kethort/esp32-bluetooth-cnc-mpg-mach4/src/PCB/BOM_PCB_open_source_MPG_2_2021-04-08.csv

ID | Name | Designator | Footprint | Quantity | Manufacturer Part | Manufacturer | Supplier | Supplier Part | _Price | JLCPCB SMD | LCSC Assembly | Paste Type | Assembly Type
1 | D2 | A+ | HDR-M-2.54_1X1 | 1 |  |  | LCSC | C81276 | $0.0048
2 | D25 | ADC | HDR-M-2.54_1X1 | 1 |  |  | LCSC | C81276 | $0.0048
3 | D4 | B+ | HDR-M-2.54_1X1 | 1 |  |  | LCSC | C81276 | $0.0048
4 | BATT+ | BATT+ | HDR-M-2.54_1X1 | 1 |  |  | LCSC | C81276 | $0.0048
5 | JUMPER2 | BATT-SW | JUMPER2 | 1
6 | 100nF | C1 | C0805 | 1 | CL21B104JBCNNNC | SAMSUNG | LCSC | C62912 | $0.0205 | Yes | Yes | expand
7 | 1000uF | C3 | CAP-SMD_BD8.0-L8.3-W8.3-RD | 1 | VEJ102M0JTR-0810 | Lelon | LCSC | C134755 | $0.1113 | Yes | Yes | expand
8 | D0 | D0 | HDR-M-2.54_1X1 | 1 |  |  | LCSC | C81276 | $0.0048
9 | D32 | EN | HDR-M-2.54_1X1 | 1 |  |  | LCSC | C81276 | $0.0048
10 | EN | J2 | HDR-M-2.54_1X1 | 1 |  |  | LCSC | C81276 | $0.0048
11 | D13 | J3 | HDR-M-2.54_1X1 | 1 |  |  | LCSC | C81276 | $0.0048
12 | D15 | J4 | HDR-M-2.54_1X1 | 1 |  |  | LCSC | C81276 | $0.0048
13 | D21 | J6 | HDR-M-2.54_1X1 | 1 |  |  | LCSC | C81276 | $0.0048
14 | D19 | J7 | HDR-M-2.54_1X1 | 1 |  |  | LCSC | C81276 | $0.0048
15 | D18 | J8,J12 | HDR-M-2.54_1X1 | 2 |  |  | LCSC | C81276 | $0.0048
16 | NC | J11 | HDR-M-2.54_1X1 | 1 |  |  | LCSC | C81276 | $0.0048
17 | D23 | J5,J13 | HDR-M-2.54_1X1 | 2 |  |  | LCSC | C81276 | $0.0048
18 | D27 | J14 | HDR-M-2.54_1X1 | 1 |  |  | LCSC | C81276 | $0.0048
19 | D26 | J23 | HDR-M-2.54_1X1 | 1 |  |  | LCSC | C81276 | $0.0048
20 | 3V3 | 3V3,J10,J26,P3V | HDR-M-2.54_1X1 | 4 |  |  | LCSC | C81276 | $0.0048
21 | GND | GND,J9,J24,J29,PGND | HDR-M-2.54_1X1 | 5 |  |  | LCSC | C81276 | $0.0048
22 | 10K | R1 | R0603 | 1 | SDNT1608X103F3450FTF | Sunlord | LCSC | C95953 | $0.043 |  |  | expand | smtWeld
23 | RX | RX | HDR-M-2.54_1X1 | 1 |  |  | LCSC | C81276 | $0.0048
24 | TX | TX | HDR-M-2.54_1X1 | 1 |  |  | LCSC | C81276 | $0.0048
25 | ESP32-WROOM-32U | U1 | WIFIM-SMD_38P-L19.2-W18.0-P1.27 | 1 | ESP32-WROOM-32U | Espressif Systems | LCSC | C328062 | $3.259091 |  | Yes | expand | smtWeld
26 | HT7333-A | U4 | SOT-89-3_L4.5-W2.5-P1.50-LS4.2-BR | 1 | HT7333-A | HOLTEK | LCSC | C21583 | $0.1849 | Yes | Yes | expand | smtWeld
