kethort/esp32-bluetooth-cnc-mpg-mach4/src/3d Print Files/mpg-top.stl

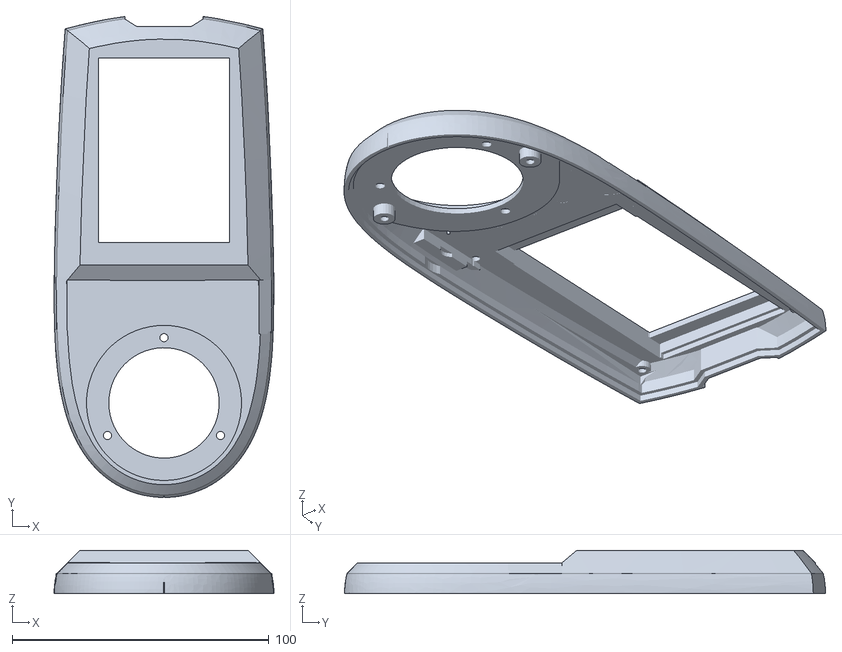
[picture p10: CAD file, 2021-04-23]
src/3d Print Files/mpg-top.stl
85.6 x 187.4 x 16.9
