kethort/esp32-bluetooth-cnc-mpg-mach4/src/3d Print Files/screen-bracket.stl

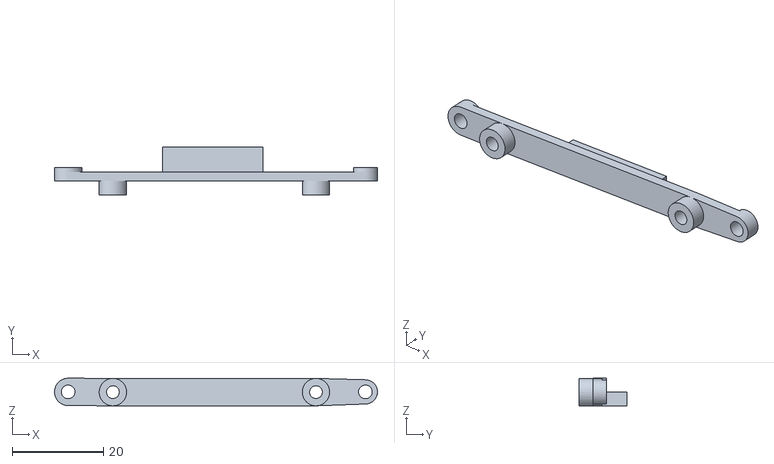
[picture p11: CAD file, 2021-04-23]
src/3d Print Files/screen-bracket.stl
70.6 x 10.5 x 6.05
