kethort/esp32-bluetooth-cnc-mpg-mach4/src/3d Print Files/mpg-bottom.stl

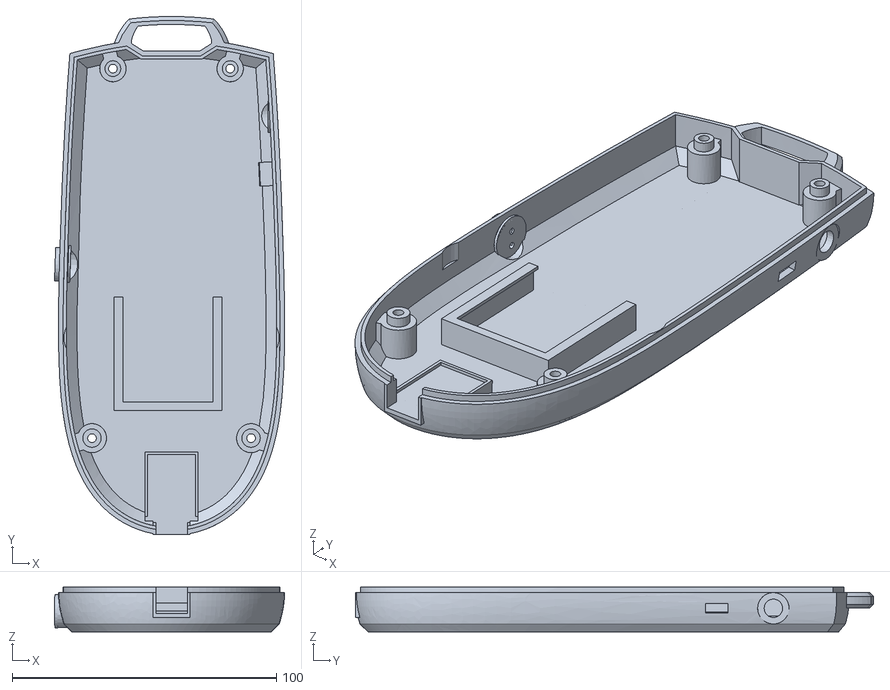
[picture p12: CAD file, 2021-04-23]
src/3d Print Files/mpg-bottom.stl
87.1 x 196.2 x 17.0
