kethort/esp32-bluetooth-cnc-mpg-mach4/(threads)

Thread 1 (2022-05-31):

I want to build me one of these, can you add a list of parts

njhurst, 2022-05-31:
besides the esp32, what do I need to reproduce your work?

kethort, 2022-06-01:
The PCB design files are included in the repo. I will update the repo when I get time with parts list but for now you can get the parts list from the TCP Modbus variant of this DIY MPG Handwheel at this repo: https://github.com/kethort/esp32-cnc-mpg-handwheel-conversion-mach4. The case is 3d printed and the 3d design files are included in this repo.

Closed 2022-06-05.
