kethort/esp32-bluetooth-cnc-mpg-mach4/(commit log)

2021-02-07 updated arduino sketches
2021-03-15 added timer to trigger keyboard enable
2021-04-23 finalized PCB and 3d print files
2021-04-23 added Arduino libraries
2021-04-23 added 3d print files and pcb gerber
    [BOM_PCB_open_source_MPG_2_2021-04-08.csv, PickAndPlace_PCB_open_source_MPG_2_2021-04-08.csv, mpg-bottom.stl, mpg-top.stl, screen-bracket.stl]
2022-02-01 added libraries, fixed display
    [ESP32-Bluetooth-MPG-ILI9341-Display.ino]
2022-02-17 added current fw builds
2022-08-31 add PCB files/instructions
